NeuroRehack/WMORE/Documentation/CAD_Models/Case_dimensions.png

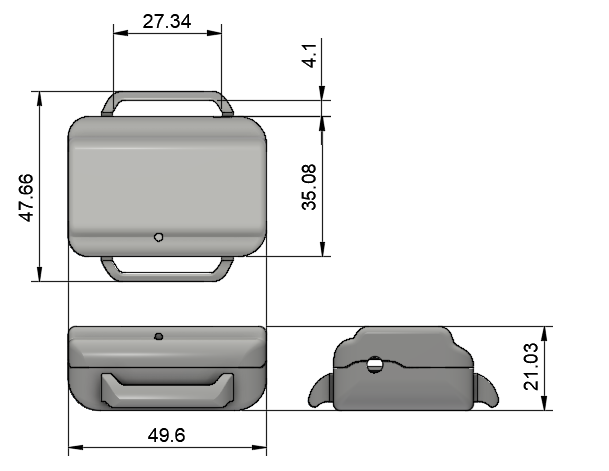
Documentation/CAD_Models/Case_dimensions.png
