NeuroRehack/WMORE/Documentation/Images/16832-SparkFun_OpenLog_Artemis-02a_600x600-293528370.jpg

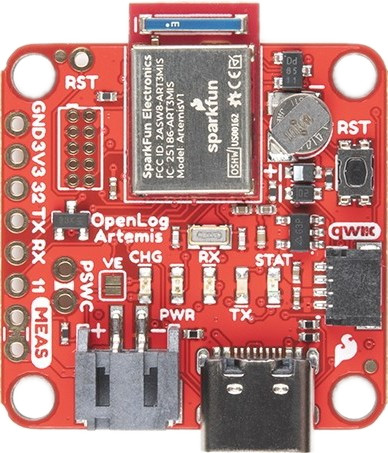
Documentation/Images/16832-SparkFun_OpenLog_Artemis-02a_600x600-293528370.jpg
