NeuroRehack/WMORE/Documentation/Images/16832-SparkFun_OpenLog_Artemis-03.jpg

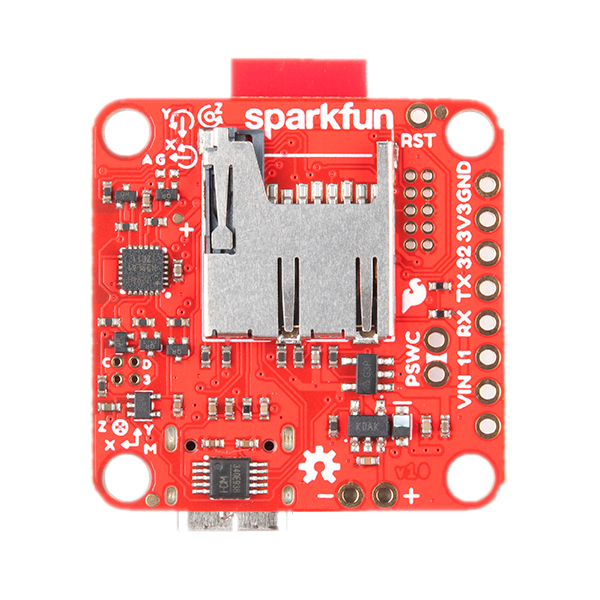
Documentation/Images/16832-SparkFun_OpenLog_Artemis-03.jpg
