NeuroRehack/WMORE/Documentation/Images/arduino-nano-33-ble-sense-pinout.png

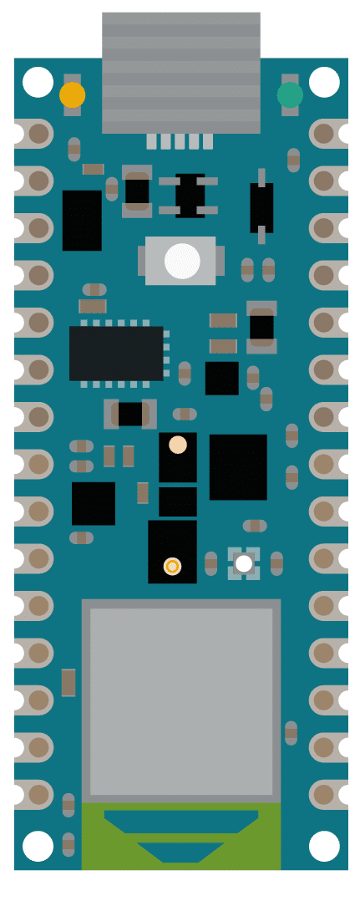
Documentation/Images/arduino-nano-33-ble-sense-pinout.png
