NeuroRehack/WMORE/Documentation/Images/Arduino-Nano-33-BLE-Sense-with-Headers-01.jpg

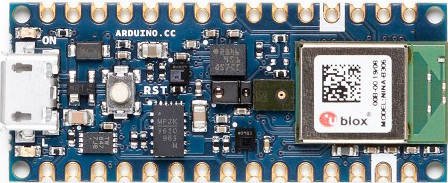
Documentation/Images/Arduino-Nano-33-BLE-Sense-with-Headers-01.jpg
