NeuroRehack/WMORE/Documentation/Images/Push Button Screenshot 2023-03-13 141330.png

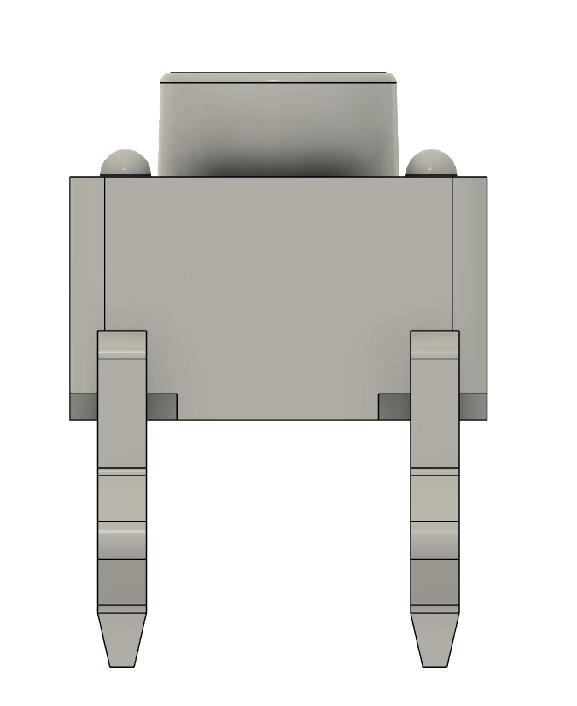
Documentation/Images/Push Button Screenshot 2023-03-13 141330.png
