NeuroRehack/WMORE/Documentation/Images/Screenshot 2023-03-13 132137.png

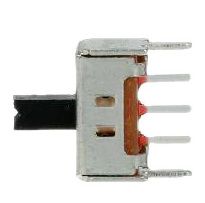
Documentation/Images/Screenshot 2023-03-13 132137.png
