NeuroRehack/WMORE/Documentation/Images/Screenshot 2023-03-13 134348.png

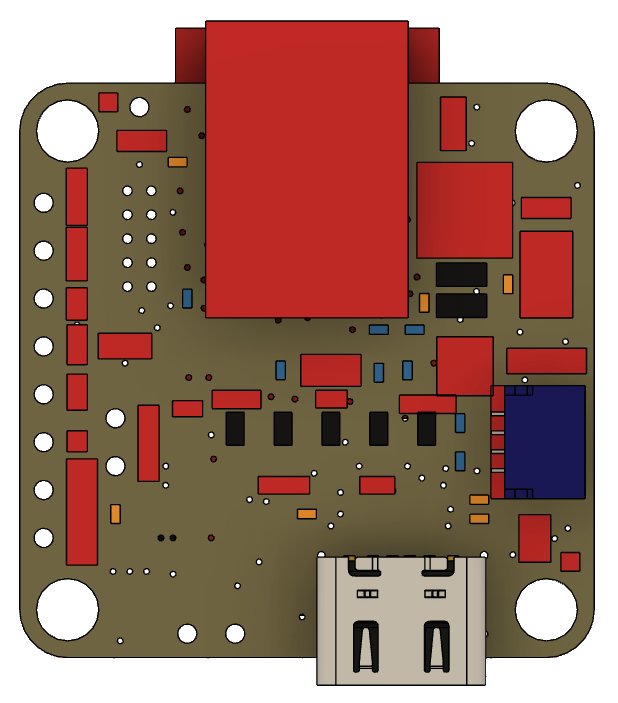
Documentation/Images/Screenshot 2023-03-13 134348.png
