NeuroRehack/WMORE/Documentation/Images/Screenshot 2023-03-13 135710.png

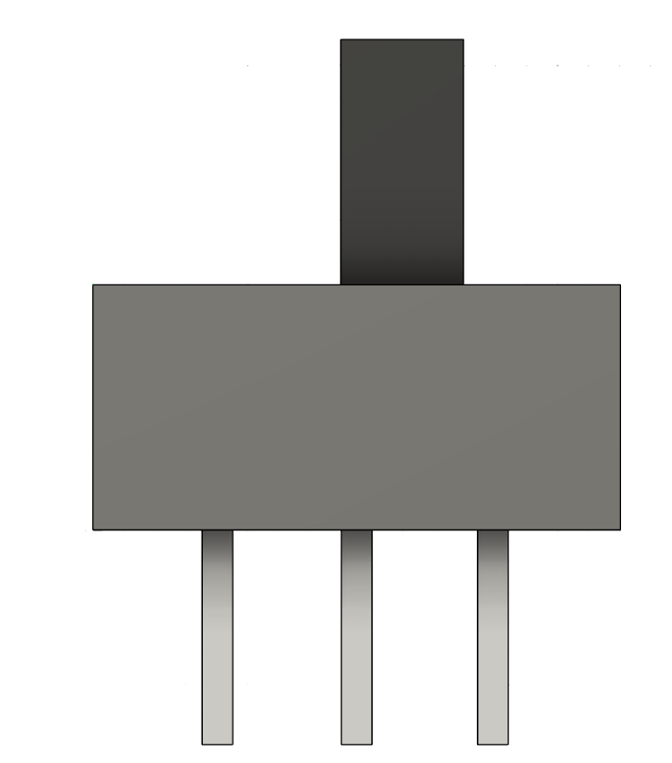
Documentation/Images/Screenshot 2023-03-13 135710.png
