NeuroRehack/WMORE/Documentation/Images/Screenshot 2023-03-13 144551.png

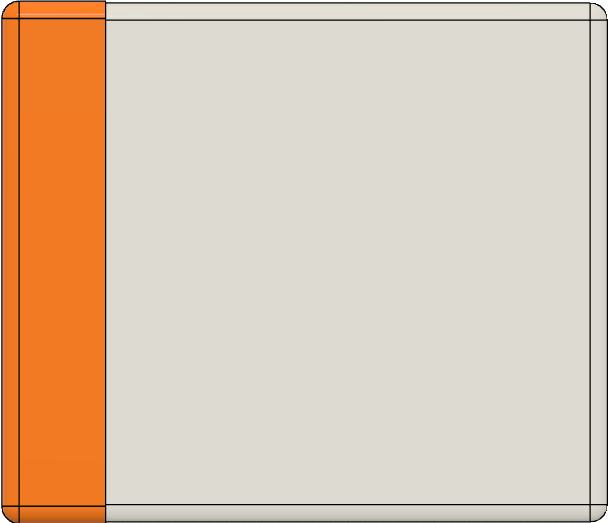
Documentation/Images/Screenshot 2023-03-13 144551.png
