NeuroRehack/WMORE/Software/images/WMORE.png

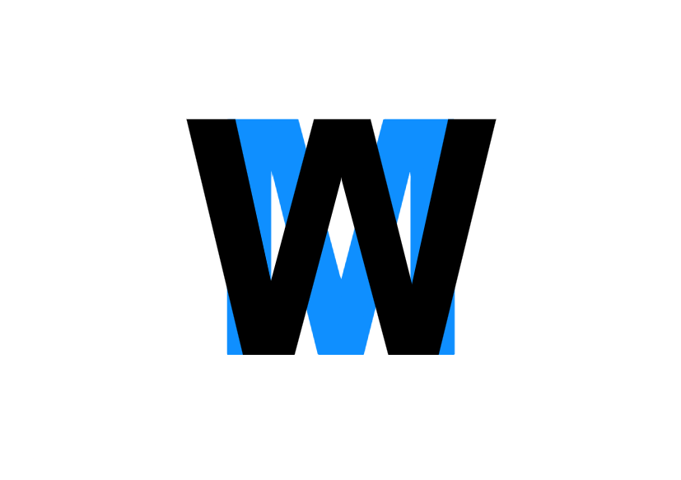
Software/images/WMORE.png
