NeuroRehack/WMORE/Software/images/WMORE_1.png

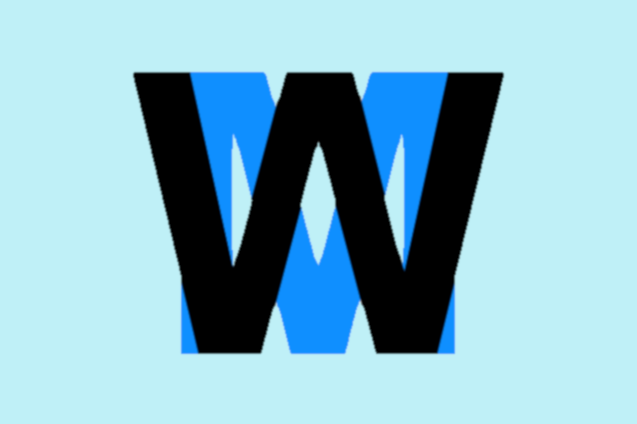
Software/images/WMORE_1.png
