NeuroRehack/WMORE/Documentation/CAD_Models/WMORE_Bottom.obj

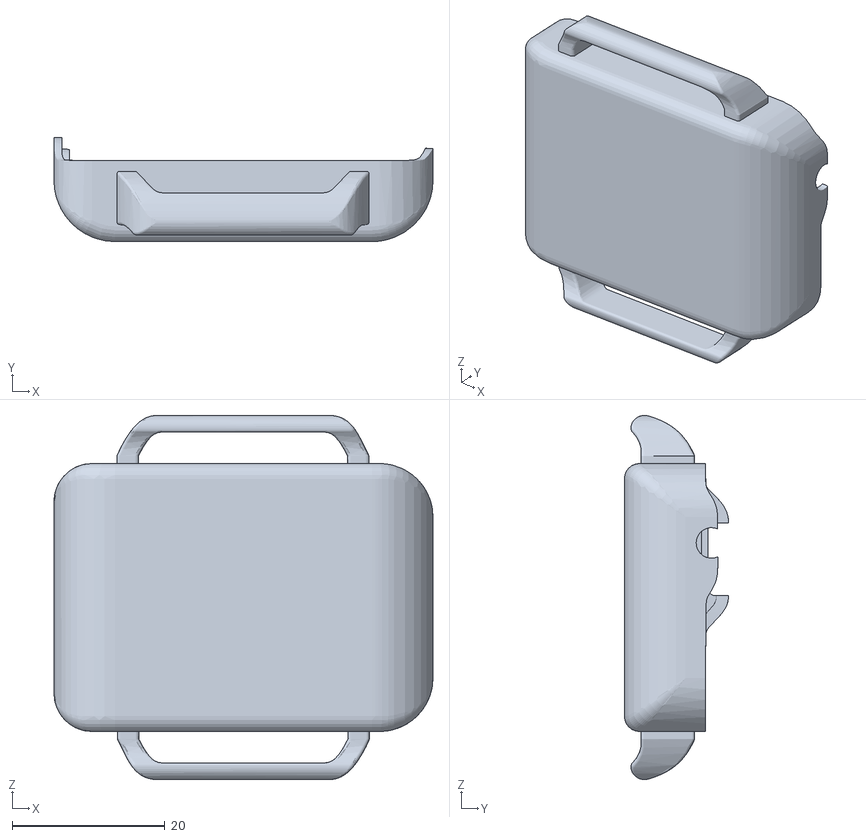
[picture p18: CAD file, 2023-08-02]
Documentation/CAD_Models/WMORE_Bottom.obj
49.6 x 13.6 x 47.7
