NeuroRehack/WMORE/Documentation/CAD_Models/WMORE_Top.obj

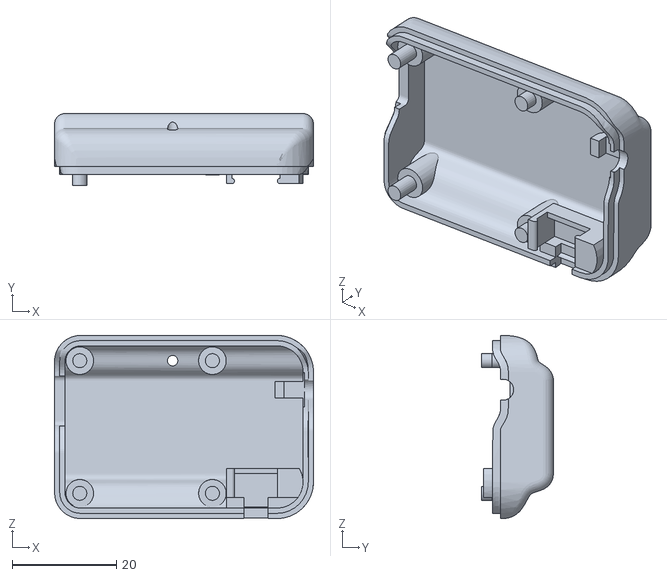
[picture p19: CAD file, 2023-08-02]
Documentation/CAD_Models/WMORE_Top.obj
49.6 x 13.8 x 35.1
