NeuroRehack/WMORE/Documentation/WMORE_Hub_Tutorial_thumbnail.png

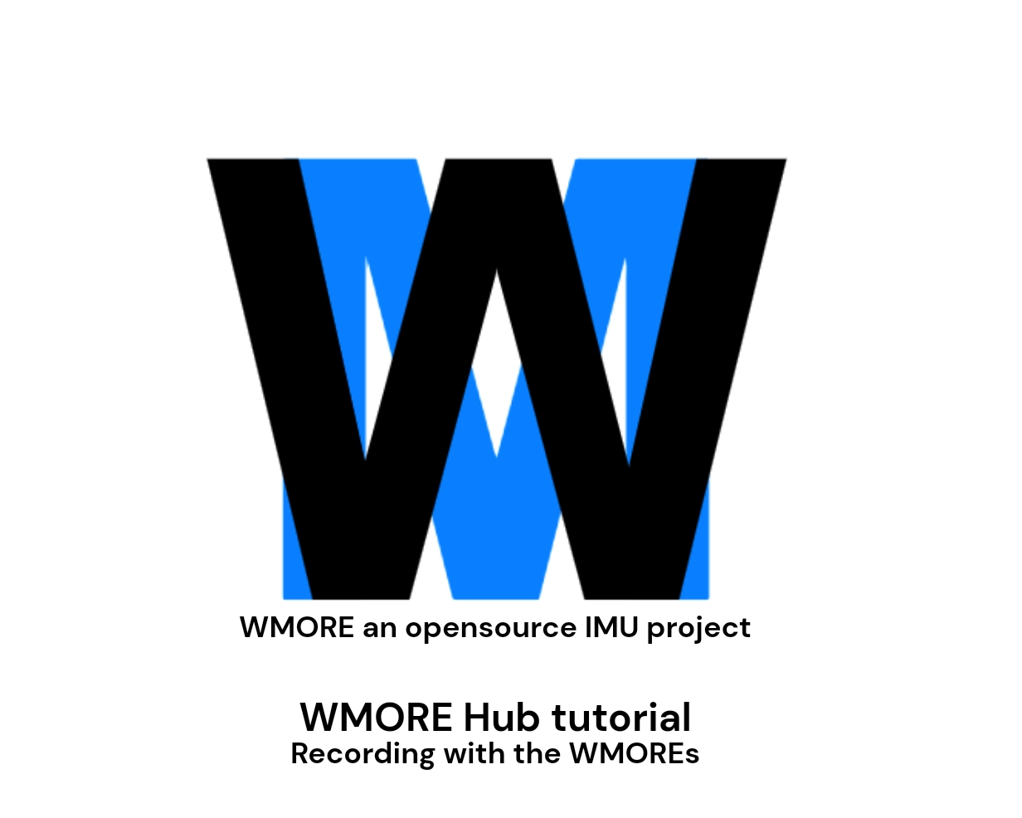
Documentation/WMORE_Hub_Tutorial_thumbnail.png
