NeuroRehack/WMORE/Documentation/Case_Mechanical_Drawing.pdf

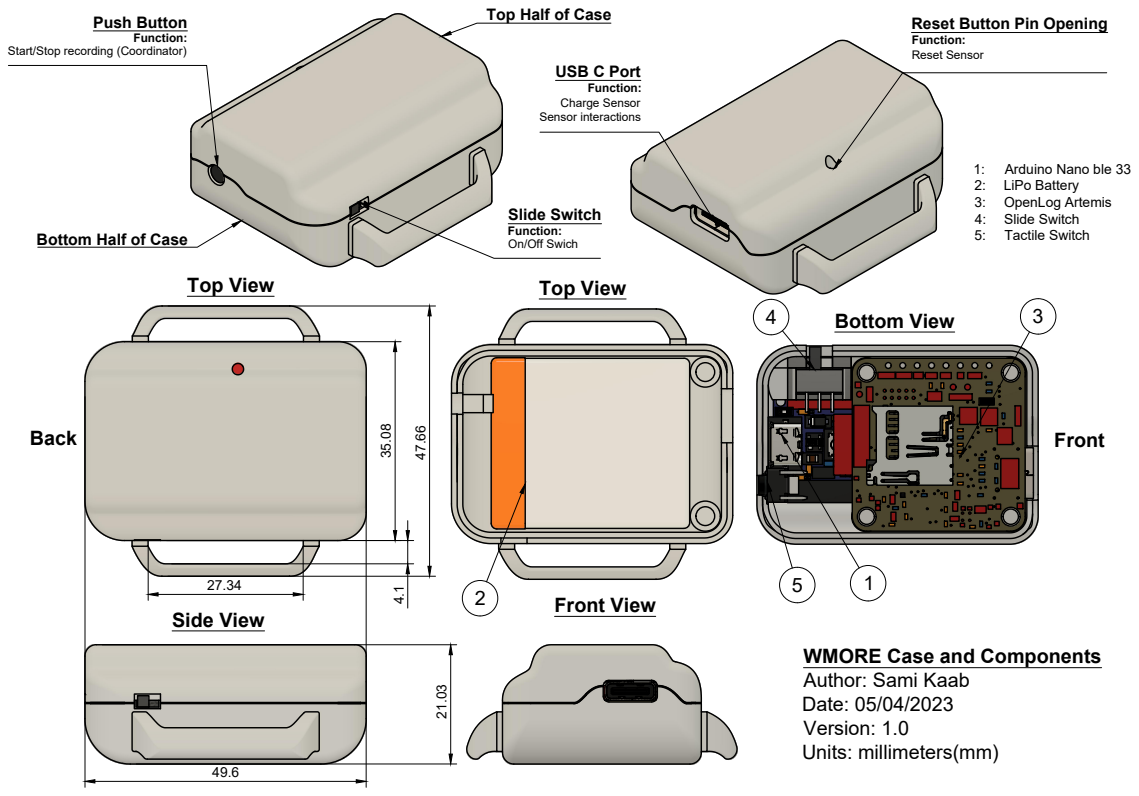
[picture p21: page 1]
Push Button; USB C Port; Charge Sensor Sensor interactions; Top View; Side View; Front View; Bottom View; Arduino Nano ble 33; LiPo Battery; OpenLog Artemis; Slide Switch; Tactile Switch

Top Half of Case

Reset Button Pin Opening
Function:
Reset Sensor

Start/Stop recording (Coordinator)

Slide Switch
On/Off Swich

Bottom Half of Case

WMORE Case and Components
Author: Sami Kaab
Date: 05/04/2023
Version: 1.0
Units: millimeters(mm)
