NeuroRehack/WMORE/Firmware/WMORE_Openlog_Coordinator/autoDetect.ino

/*
  Autodetect theory of operation:

  This is a simplified version that only handles basic I2C device detection.
  It scans the I2C bus for devices and stores them in a linked list.
*/

//Given node number, get a pointer to the node
node *getNodePointer(uint8_t nodeNumber)
{
  //Search the list of nodes
  node *temp = head;

  int counter = 0;
  while (temp != NULL)
  {
    if (nodeNumber == counter)
      return (temp);
    counter++;
    temp = temp->next;
  }

  return (NULL);
}

node *getNodePointer(deviceType_e deviceType, uint8_t address, uint8_t muxAddress, uint8_t portNumber)
{
  //Search the list of nodes
  node *temp = head;
  while (temp != NULL)
  {
    if (temp->address == address)
      if (temp->muxAddress == muxAddress)
        if (temp->portNumber == portNumber)
          if (temp->deviceType == deviceType)
            return (temp);

    temp = temp->next;
  }
  return (NULL);
}

//Given nodenumber, pull out the device type
deviceType_e getDeviceType(uint8_t nodeNumber)
{
  node *temp = getNodePointer(nodeNumber);
  if (temp == NULL) return (DEVICE_UNKNOWN_DEVICE);
  return (temp->deviceType);
}

//Given nodeNumber, return the config pointer
void *getConfigPointer(uint8_t nodeNumber)
{
  //Search the list of nodes
  node *temp = getNodePointer(nodeNumber);
  if (temp == NULL) return (NULL);
  return (temp->configPtr);
}

//Given a bunch of ID'ing info, return the config pointer to a node
void *getConfigPointer(deviceType_e deviceType, uint8_t address, uint8_t muxAddress, uint8_t portNumber)
{
  //Search the list of nodes
  node *temp = getNodePointer(deviceType, address, muxAddress, portNumber);
  if (temp == NULL) return (NULL);
  return (temp->configPtr);
}

//Add a device to the linked list
//Creates a class but does not begin or configure the device
bool addDevice(deviceType_e deviceType, uint8_t address, uint8_t muxAddress, uint8_t portNumber)
{
  //Ignore devices we've already logged
  if (deviceExists(deviceType, address, muxAddress, portNumber) == true) return false;

  node *temp = new node; //Create the node in memory

  //Setup this node
  temp->deviceType = deviceType;
  temp->address = address;
  temp->muxAddress = muxAddress;
  temp->portNumber = portNumber;

  //Link to next node
  temp->next = NULL;
  if (head == NULL)
  {
    head = temp;
    tail = temp;
    temp = NULL;
  }
  else
  {
    tail->next = temp;
    tail = temp;
  }

  return true;
}

//Begin()'s all devices in the node list
bool beginQwiicDevices()
{
  bool everythingStarted = true;

  waitForQwiicBusPowerDelay(); // Wait while the qwiic devices power up - if required

  qwiicPowerOnDelayMillis = settings.qwiicBusPowerUpDelayMs; // Set qwiicPowerOnDelayMillis to the _minimum_ defined by settings.qwiicBusPowerUpDelayMs. It will be increased if required.

  //Step through the list
  node *temp = head;

  if (temp == NULL)
  {
    printDebug(F("beginQwiicDevices: No devices detected\r\n"));
    return (true);
  }

  while (temp != NULL)
  {
    if (settings.printDebugMessages == true)
    {
      SerialPrintf2("beginQwiicDevices: attempting to begin deviceType %s", getDeviceName(temp->deviceType));
      SerialPrintf2(" at address 0x%02X\r\n", temp->address);
    }

    temp->online = true; // For now, just mark all devices as online
    temp = temp->next;
  }

  return everythingStarted;
}

//Pretty print all the online devices
int printOnlineDevice()
{
  int deviceCount = 0;

  //Step through the list
  node *temp = head;

  if (temp == NULL)
  {
    printDebug(F("printOnlineDevice: No devices detected\r\n"));
    return (0);
  }

  while (temp != NULL)
  {
    char sensorOnlineText[75];
    if (temp->online)
    {
      sprintf(sensorOnlineText, "%s online at address 0x%02X\r\n", getDeviceName(temp->deviceType), temp->address);
      deviceCount++;
    }
    else
    {
      sprintf(sensorOnlineText, "%s failed to respond\r\n", getDeviceName(temp->deviceType));
    }
    SerialPrint(sensorOnlineText);

    temp = temp->next;
  }

  if (settings.printDebugMessages == true)
  {
    SerialPrintf2("Device count: %d\r\n", deviceCount);
  }

  return (deviceCount);
}

//Given the node number, apply the node's configuration settings to the device
void configureDevice(uint8_t nodeNumber)
{
  node *temp = getNodePointer(nodeNumber);
  configureDevice(temp);
}

//Given the node pointer, apply the node's configuration settings to the device
void configureDevice(node * temp)
{
  uint8_t deviceType = (uint8_t)temp->deviceType;
  SerialPrintf3("configureDevice: Unknown device type %d: %s\r\n", deviceType, getDeviceName((deviceType_e)deviceType));
}

//Apply device settings to each node
void configureQwiicDevices()
{
  //Step through the list
  node *temp = head;

  while (temp != NULL)
  {
    configureDevice(temp);
    temp = temp->next;
  }

  //Now that the settings are loaded and the devices are configured,
  //try for 400kHz but reduce to 100kHz if certain devices are attached
  setMaxI2CSpeed();
}

//Returns a pointer to the menu function that configures this particular device type
FunctionPointer getConfigFunctionPtr(uint8_t nodeNumber)
{
  return NULL;
}

//Search the linked list for a given address
//Returns true if this device address already exists in our system
bool deviceExists(deviceType_e deviceType, uint8_t address, uint8_t muxAddress, uint8_t portNumber)
{
  node *temp = head;
  while (temp != NULL)
  {
    if (temp->address == address)
      if (temp->muxAddress == muxAddress)
        if (temp->portNumber == portNumber)
          if (temp->deviceType == deviceType) return (true);

    temp = temp->next;
  }
  return (false);
}

//Bubble sort the given linked list by the device address
//https://www.geeksforgeeks.org/c-program-bubble-sort-linked-list/
void bubbleSortDevices(struct node * start)
{
  int swapped, i;
  struct node *ptr1;
  struct node *lptr = NULL;

  //Checking for empty list
  if (start == NULL) return;

  do
  {
    swapped = 0;
    ptr1 = start;

    while (ptr1->next != lptr)
    {
      if (ptr1->address > ptr1->next->address)
      {
        swap(ptr1, ptr1->next);
        swapped = 1;
      }
      ptr1 = ptr1->next;
    }
    lptr = ptr1;
  }
  while (swapped);
}

//Swap data of two nodes a and b
void swap(struct node * a, struct node * b)
{
  node temp;

  temp.deviceType = a->deviceType;
  temp.address = a->address;
  temp.portNumber = a->portNumber;
  temp.muxAddress = a->muxAddress;
  temp.online = a->online;
  temp.classPtr = a->classPtr;
  temp.configPtr = a->configPtr;

  a->deviceType = b->deviceType;
  a->address = b->address;
  a->portNumber = b->portNumber;
  a->muxAddress = b->muxAddress;
  a->online = b->online;
  a->classPtr = b->classPtr;
  a->configPtr = b->configPtr;

  b->deviceType = temp.deviceType;
  b->address = temp.address;
  b->portNumber = temp.portNumber;
  b->muxAddress = temp.muxAddress;
  b->online = temp.online;
  b->classPtr = temp.classPtr;
  b->configPtr = temp.configPtr;
}

//Given an address, returns the device type if it responds as we would expect
deviceType_e testDevice(uint8_t i2cAddress, uint8_t muxAddress, uint8_t portNumber)
{
  SerialPrintf2("Unknown device at address (0x%02X)\r\n", i2cAddress);
  return DEVICE_UNKNOWN_DEVICE;
}

//Given a device number return the string associated with that entry
const char* getDeviceName(deviceType_e deviceNumber)
{
  switch (deviceNumber)
  {
    case DEVICE_UNKNOWN_DEVICE:
      return "Unknown device";
      break;
    default:
      return "Unknown Status";
      break;
  }
  return "None";
}
