NeuroRehack/WMORE/(commit log)

2023-03-22 add doc on wiring and firmware
2023-03-22 adds folder with documentation material
2023-03-28 add hover tip to several buttons
2023-04-03 allows downloading from multiple devices
2023-04-05 add doc on led colour sequences
2023-04-05 Adds CASE fbx models
2023-04-05 adds openlog arduino code
2023-04-05 Adds Assembly section to ReadMe file
2023-08-02 Updates documentation
    [bottom.obj, top.obj]
2023-09-01 updates schematics for switch wiring changes
2023-09-04 fixes wiring schematic mistake
2023-09-06 Updates wiring schematics
2023-09-06 use character "i" command to get device type
2023-09-06 sets tx to gpio out pin high when sampling
2023-09-08 implements threading for getting device info
2023-09-14 adds scripts for led status and battery monitoring
2023-09-14 implements file checking for device file download
2025-05-26 Add Dev container to automate arduino environment setup for openlog firmwares
2025-05-26 Refactor Arduino environment setup and clean up unused code. Remove all redundant librairies and associated code.
2025-05-26 Add non-root user for UART access in Dockerfile and streamline udev rules setup
